mengstr/XSNOR/Assets/XSNOR-Megacalculator.bmp

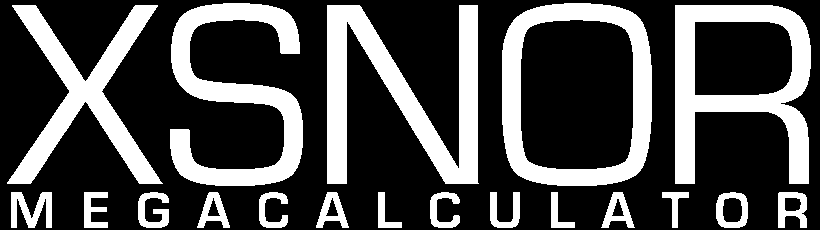
Assets/XSNOR-Megacalculator.bmp
