mengstr/XSNOR/Spice/main_test.asc

R1: res; 20
V1: voltage; 3; Rser=0
V2: voltage; PULSE(0.1 2.9 10m 100n 100n 20m 40m 1)
X1: AddSub
X2: AddSub
Named nets: 0, +, A
.tran 50m
