mengstr/XSNOR/Spice/Jonsson.asc

X1: NOR2
X2: NOR2
X3: NOR2
X4: NOR2
X5: NOR2
X6: NOR2
X7: NOR3
X8: NOR3
X9: INV
Named nets: +, CLK, J, K, CLR, Q, /Q
