mengstr/XSNOR/Spice/Jonsson12.asc

V1: voltage; 3
V2: voltage; PULSE(0 3 50m 0.1m 0.1m 5m 10m 24)
V3: voltage; PULSE(0 3 5m 0.1m 0.1m 5m 10m 1)
X1: Jonsson
X2: Jonsson
X3: Jonsson
X4: Jonsson
X5: Jonsson
X6: Jonsson
X7: NOR2
X8: NOR2
X9: NOR2
X10: NOR2
X11: NOR2
X12: NOR2
X13: NOR2
X14: NOR2
X15: NOR2
X16: NOR2
X17: NOR2
X18: NOR2
X19: Jonsson
X20: Jonsson
X21: Jonsson
X22: Jonsson
X23: Jonsson
X24: Jonsson
X25: NOR3
X26: NOR3
X27: NOR3
X28: NOR3
X29: NOR3
X30: NOR3
X31: NOR3
X32: NOR3
X33: NOR3
X34: NOR3
X35: NOR3
X36: NOR3
X37: Jonsson
X38: Jonsson
X39: Jonsson
X40: Jonsson
X41: Jonsson
X42: Jonsson
X43: NOR3
X44: NOR3
X45: NOR3
X46: NOR3
X47: NOR3
X48: NOR3
X49: NOR3
X50: NOR3
X51: NOR3
X52: NOR3
X53: NOR3
X54: NOR3
Named nets: +, 0, CLK, CLR, Q0, Q1, Q2, Q3, Q4, Q5, Q6, Q7, Q8, Q9, Q10, Q11, QQ0, QQ1, QQ2, QQ3, QQ4, QQ5, QQ6, QQ7, QQ8, QQ9, QQ10, QQ11, QQQ0, QQQ1, QQQ2, QQQ3, QQQ4, QQQ5, QQQ7, QQQ8, QQQ9, QQQ10, QQQ11
.tran 300m
