mengstr/XSNOR/Spice/_Keyboard.asc

V1: voltage; 3
V2: voltage; PULSE(0 3 0m 1m 1m 50m 100m 1)
V3: voltage; PULSE(0 3 100m 1m 1m 50m 100m 1)
V4: voltage; PULSE(0 3 200m 1m 1m 50m 100m 1)
V5: voltage; PULSE(0 3 300m 1m 1m 50m 100m 1)
V6: voltage; PULSE(0 3 400m 1m 1m 50m 100m 1)
V7: voltage; PULSE(0 3 500m 1m 1m 50m 100m 1)
V8: voltage; PULSE(0 3 600m 1m 1m 50m 100m 1)
V9: voltage; PULSE(0 3 700m 1m 1m 50m 100m 1)
V10: voltage; PULSE(0 3 800m 1m 1m 50m 100m 1)
V11: voltage; PULSE(0 3 900m 1m 1m 50m 100m 1)
V12: voltage; PULSE(0 3 1000m 1m 1m 50m 100m 1)
V13: voltage; PULSE(0 3 25m 1n 1n 1n 100m 10)
X1: Keyboard
Named nets: 0, +, PULSE, D0, D1, D2, D3, STB, key0, key1, key2, key3, key4, key5, key6, key7, key8, key9, keyx, AKD
.tran 999m
