mengstr/XSNOR/Spice/Keyboard.asc

C1: cap; 100n
C2: cap; 100n
M1: nmos; 2N7002
M2: nmos; 2N7002
M3: nmos; 2N7002
M4: nmos; 2N7002
M5: nmos; 2N7002
M6: nmos; 2N7002
M7: nmos; 2N7002
M8: nmos; 2N7002
M9: nmos; 2N7002
M10: nmos; 2N7002
M11: nmos; 2N7002
M12: nmos; 2N7002
M13: nmos; 2N7002
M14: nmos; 2N7002
M15: nmos; 2N7002
M16: nmos; 2N7002
M17: nmos; 2N7002
M18: nmos; 2N7002
M19: nmos; 2N7002
M20: nmos; 2N7002
M21: nmos; 2N7002
M22: nmos; 2N7002
M23: nmos; 2N7002
M24: nmos; 2N7002
M25: nmos; 2N7002
M26: nmos; 2N7002
M28: nmos; 2N7002
M30: nmos; 2N7002
M31: nmos; 2N7002
M32: nmos; 2N7002
M33: nmos; 2N7002
M34: nmos; 2N7002
M36: nmos; 2N7002
M39: nmos; 2N7002
M40: nmos; 2N7002
R1: res; {r}
R2: res; {r}
R3: res; {r}
R4: res; {r}
R5: res; {r}
R6: res; {r}
R7: res; {r}
R8: res; {r}
R9: res; {r}
R10: res; {r}
R11: res; {r}
R12: res; {r}
R13: res; {r}
R14: res; {r}
R15: res; {r}
R16: res; {r}
R17: res; {r}
R18: res; {r}
R19: res; {r}
R20: res; {r}
R21: res; {r}
R22: res; {r}
R23: res; {r}
R24: res; {r}
R25: res; {r}
R26: res; {r}
R27: res; {r}
V2: voltage; 3; Rser=100
Named nets: 0, KEY0, KEY1, KEY2, KEY3, KEY4, KEY5, KEY6, KEY7, KEY8, KEY9, /D0, /D1, /D2, /D3, +, D0, D1, D2, D3, AKD, KEYX, STB
.tran 1500m
.param r=1Meg
