mengstr/XSNOR/Spice/AddSub.asc

X1: FA
X2: FA
X3: FA
X4: FA
X5: INV
X6: FA
X7: FA
X8: FA
X9: INV
X10: NOR2
X11: NOR2
X12: NOR2
X13: NOR2
X14: NOR2
X15: NOR2
X16: NOR2
X17: NOR2
X18: NOR2
X19: NOR2
X20: NOR2
X21: NOR2
X22: INV
X23: INV
X24: INV
X25: INV
X26: INV
Named nets: +, OP, Ci, A0, A1, A2, A3, B0, B1, B2, B3, S0, S1, S2, S3, Co
