mengstr/XSNOR/Spice/FA.asc

X1: NOR2
X2: NOR2
X3: NOR2
X4: NOR2
X5: NOR2
X6: NOR2
X7: NOR2
X8: NOR2
X9: NOR2
Named nets: +, A, B, Ci, Co, S
