mengstr/XSNOR/Spice/INV.asc

M1: nmos; 2N7002
R1: res; 1Meg
Named nets: 0, A, Q, +
