mengstr/XSNOR/Spice/main.asc

R1: res; 20
V1: voltage; 3; Rser=0
V2: voltage; PULSE(0.1 2.9 0.1 100n 100n 0.1 0.2 4)
V3: voltage; PULSE(0.2 2.8 0.2 100n 100n 0.2 0.4 2)
V4: voltage; PULSE(0.3 2.7 0.4 100n 100n 0.4 0.8 1)
X1: AddSub
X2: AddSub
X3: AddSub
X4: AddSub
X5: AddSub
X6: AddSub
X7: AddSub
X8: AddSub
X9: AddSub
X10: AddSub
Named nets: 0, +, A, B
.tran 0.8s
