mengstr/XSNOR/Spice/NOR3.asc

M1: nmos; 2N7002
M2: nmos; 2N7002
M3: nmos; 2N7002
R1: res; 3meg
Named nets: 0, A, Q, +, B, C
