mengstr/XSNOR/(list of files, drawings)

Other design files:
Logisim/Johnson.circ
Logisim/ShiftRegister.circ
