mengstr/XSNOR/Eagle/ShiftReg.brd

## EAGLE design Eagle/ShiftReg.brd (2018-01-12)

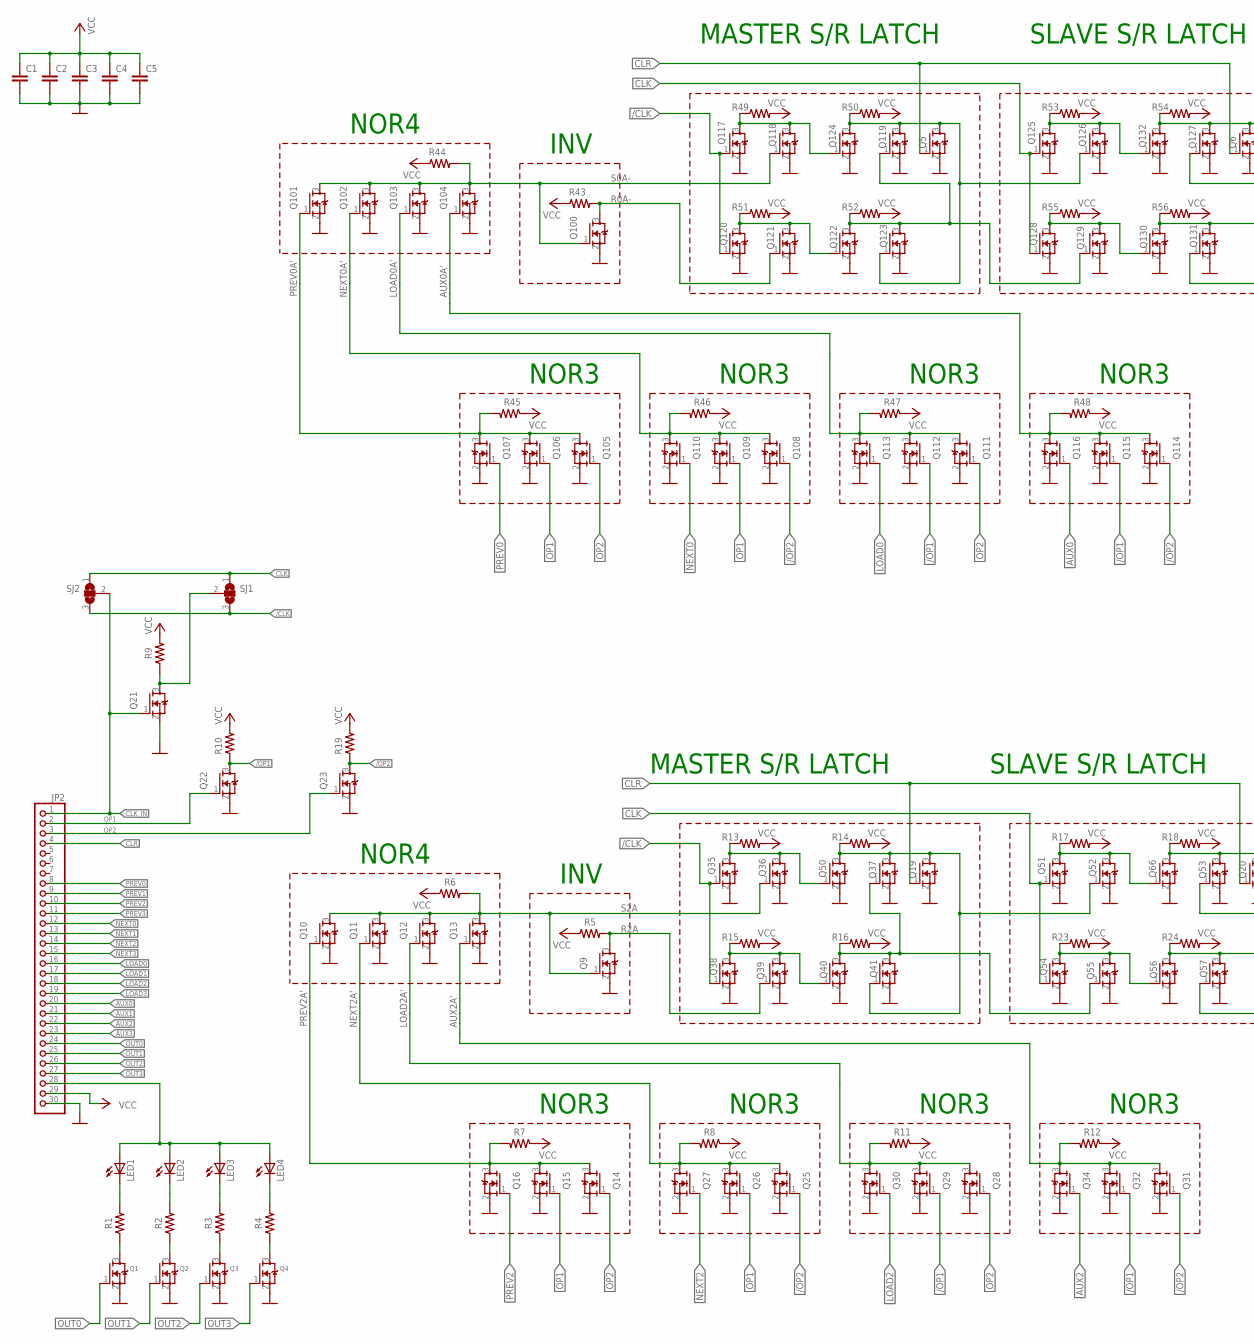
[picture p2: schematic ShiftReg.sch, part in row 1, column 1]

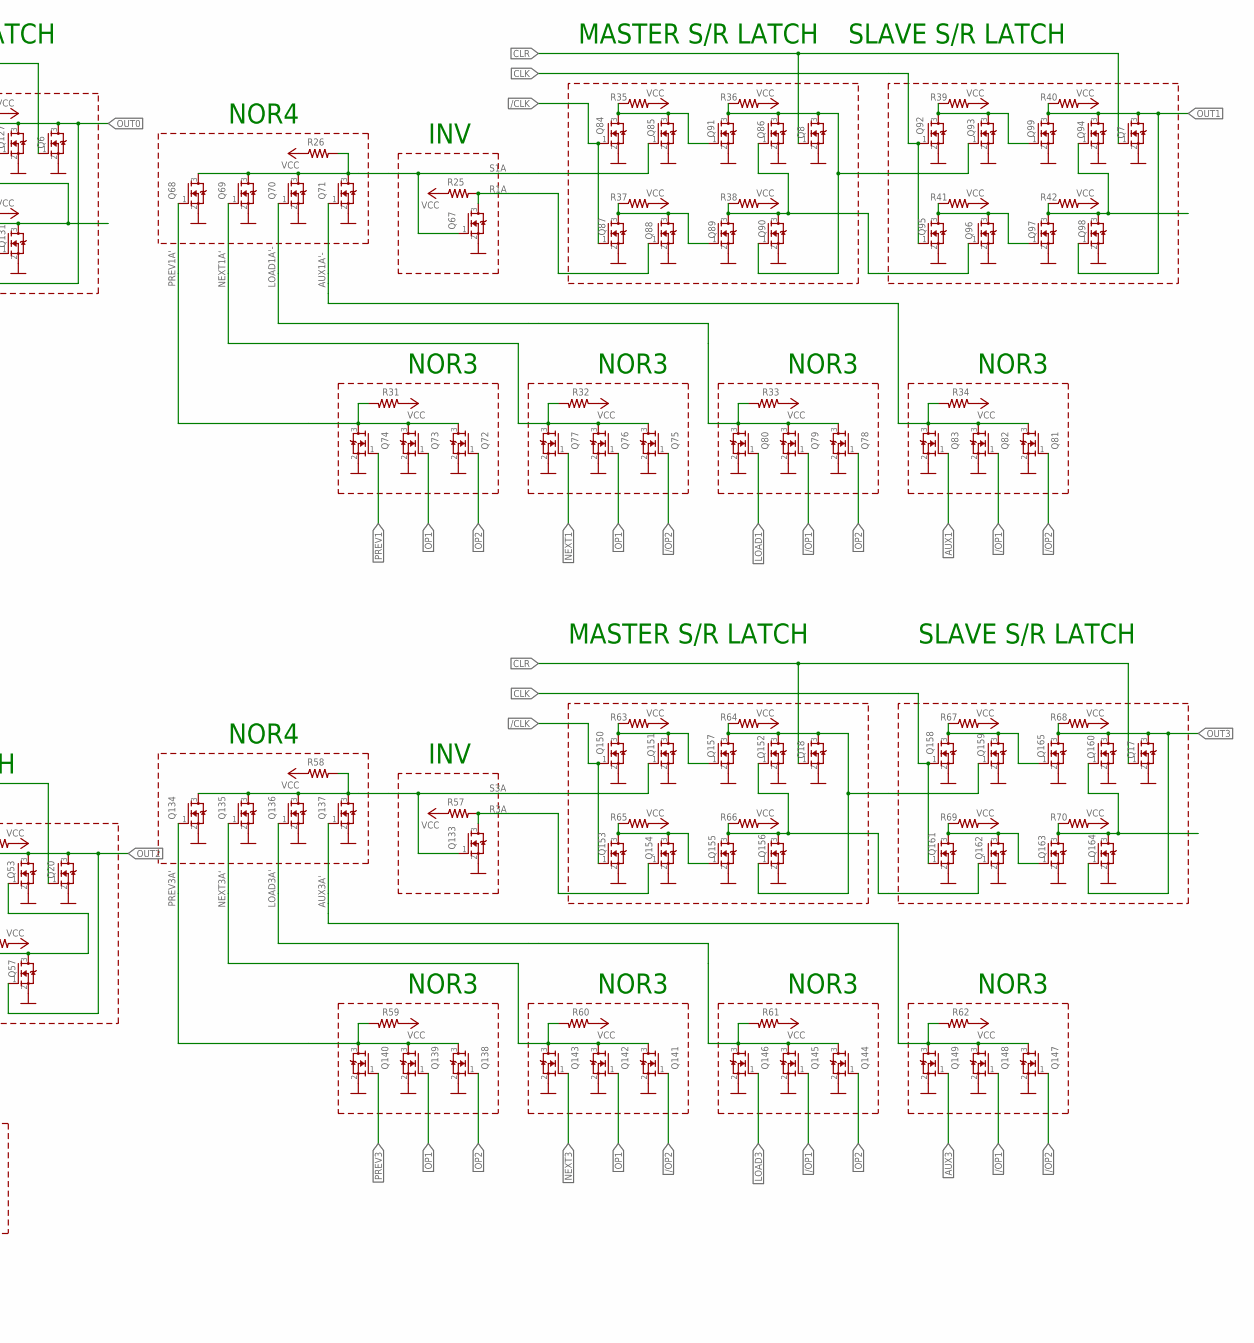
[picture p3: schematic ShiftReg.sch, part in row 1, column 2]

Parts:
C1, C2, C3, C4, C5: C-EUC0805K; C0805K
JP2: PINHD-1X30; 1X30
LED1, LED2, LED3, LED4: LEDSQR2X5; LED2X5
Q1, Q2, Q3, Q4: NMOSREFLOW; SOT23
Q5, Q6, Q7, Q8, Q9, Q10, Q11, Q12, Q13, Q14, Q15, Q16, Q17, Q18, Q19, Q20, Q21, Q22, Q23, Q25, Q26, Q27, Q28, Q29, Q30, Q31, Q32, Q34, Q35, Q36, Q37, Q38, Q39, Q40, Q41, Q50, Q51, Q52, Q53, Q54, Q55, Q56, Q57, Q66, Q67, Q68, Q69, Q70, Q71, Q72, Q73, Q74, Q75, Q76, Q77, Q78, Q79, Q80, Q81, Q82, Q83, Q84, Q85, Q86, Q87, Q88, Q89, Q90, Q91, Q92, Q93, Q94, Q95, Q96, Q97, Q98, Q99, Q100, Q101, Q102, Q103, Q104, Q105, Q106, Q107, Q108, Q109, Q110, Q111, Q112, Q113, Q114, Q115, Q116, Q117, Q118, Q119, Q120, Q121, Q122, Q123, Q124, Q125, Q126, Q127, Q128, Q129, Q130, Q131, Q132, Q133, Q134, Q135, Q136, Q137, Q138, Q139, Q140, Q141, Q142, Q143, Q144, Q145, Q146, Q147, Q148, Q149, Q150, Q151, Q152, Q153, Q154, Q155, Q156, Q157, Q158, Q159, Q160, Q161, Q162, Q163, Q164, Q165: 310mA/60V/1.6Ω; SOT23
R1, R2, R3, R4, R5, R6, R7, R8, R9, R10, R11, R12, R13, R14, R15, R16, R17, R18, R19, R23, R24, R25, R26, R31, R32, R33, R34, R35, R36, R37, R38, R39, R40, R41, R42, R43, R44, R45, R46, R47, R48, R49, R50, R51, R52, R53, R54, R55, R56, R57, R58, R59, R60, R61, R62, R63, R64, R65, R66, R67, R68, R69, R70: 0805
SJ1, SJ2: SJ2W; SJ_2

Connections:
/CLK: Q35.1 (G), Q38.1 (G), Q84.1 (G), Q87.1 (G), Q117.1 (G), Q120.1 (G), Q150.1 (G), Q153.1 (G), SJ1.3, SJ2.3
/OP1: Q22.3 (D), Q29.1 (G), Q32.1 (G), Q79.1 (G), Q82.1 (G), Q112.1 (G), Q115.1 (G), Q145.1 (G), Q148.1 (G), R10.1
/OP2: Q23.3 (D), Q25.1 (G), Q31.1 (G), Q75.1 (G), Q81.1 (G), Q108.1 (G), Q114.1 (G), Q141.1 (G), Q147.1 (G), R19.1
AUX0: JP2.20, Q116.1 (G)
AUX0A': Q104.1 (G), Q114.3 (D), Q115.3 (D), Q116.3 (D), R48.2
AUX1: JP2.21, Q83.1 (G)
AUX1A'-: Q71.1 (G), Q81.3 (D), Q82.3 (D), Q83.3 (D), R34.2
AUX2: JP2.22, Q34.1 (G)
AUX2A': Q13.1 (G), Q31.3 (D), Q32.3 (D), Q34.3 (D), R12.2
AUX3: JP2.23, Q149.1 (G)
AUX3A': Q137.1 (G), Q147.3 (D), Q148.3 (D), Q149.3 (D), R62.2
CLK: Q51.1 (G), Q54.1 (G), Q92.1 (G), Q95.1 (G), Q125.1 (G), Q128.1 (G), Q158.1 (G), Q161.1 (G), SJ1.1, SJ2.1
CLK_IN: JP2.1, Q21.1 (G), SJ2.2
CLR: JP2.4, Q5.1 (G), Q6.1 (G), Q7.1 (G), Q8.1 (G), Q17.1 (G), Q18.1 (G), Q19.1 (G), Q20.1 (G)
GND: C1.2, C2.2, C3.2, C4.2, C5.2, JP2.30, Q1.2 (S), Q2.2 (S), Q3.2 (S), Q4.2 (S), Q5.2 (S), Q6.2 (S), Q7.2 (S), Q8.2 (S), Q9.2 (S), Q10.2 (S), Q11.2 (S), Q12.2 (S), Q13.2 (S), Q14.2 (S), Q15.2 (S), Q16.2 (S), Q17.2 (S), Q18.2 (S), Q19.2 (S), Q20.2 (S), Q21.2 (S), Q22.2 (S), Q23.2 (S), Q25.2 (S), Q26.2 (S), Q27.2 (S), Q28.2 (S), Q29.2 (S), Q30.2 (S), Q31.2 (S), Q32.2 (S), Q34.2 (S), Q35.2 (S), Q36.2 (S), Q37.2 (S), Q38.2 (S), Q39.2 (S), Q40.2 (S), Q41.2 (S), Q50.2 (S), Q51.2 (S), Q52.2 (S), Q53.2 (S), Q54.2 (S), Q55.2 (S), Q56.2 (S), Q57.2 (S), Q66.2 (S), Q67.2 (S), Q68.2 (S), Q69.2 (S), Q70.2 (S), Q71.2 (S), Q72.2 (S), Q73.2 (S), Q74.2 (S), Q75.2 (S), Q76.2 (S), Q77.2 (S), Q78.2 (S), Q79.2 (S), Q80.2 (S), Q81.2 (S), Q82.2 (S), Q83.2 (S), Q84.2 (S), Q85.2 (S), Q86.2 (S), Q87.2 (S), Q88.2 (S), Q89.2 (S), Q90.2 (S), Q91.2 (S), Q92.2 (S), Q93.2 (S), Q94.2 (S), Q95.2 (S), Q96.2 (S), Q97.2 (S), Q98.2 (S), Q99.2 (S), Q100.2 (S), Q101.2 (S), Q102.2 (S), Q103.2 (S), Q104.2 (S), Q105.2 (S), Q106.2 (S), Q107.2 (S), Q108.2 (S), Q109.2 (S), Q110.2 (S), Q111.2 (S), Q112.2 (S), Q113.2 (S), Q114.2 (S), Q115.2 (S), Q116.2 (S), Q117.2 (S), Q118.2 (S), Q119.2 (S), Q120.2 (S), Q121.2 (S), Q122.2 (S), Q123.2 (S), Q124.2 (S), Q125.2 (S), Q126.2 (S), Q127.2 (S), Q128.2 (S), Q129.2 (S), Q130.2 (S), Q131.2 (S), Q132.2 (S), Q133.2 (S), Q134.2 (S), Q135.2 (S), Q136.2 (S), Q137.2 (S), Q138.2 (S), Q139.2 (S), Q140.2 (S), Q141.2 (S), Q142.2 (S), Q143.2 (S), Q144.2 (S), Q145.2 (S), Q146.2 (S), Q147.2 (S), Q148.2 (S), Q149.2 (S), Q150.2 (S), Q151.2 (S), Q152.2 (S), Q153.2 (S), Q154.2 (S), Q155.2 (S), Q156.2 (S), Q157.2 (S), Q158.2 (S), Q159.2 (S), Q160.2 (S), Q161.2 (S), Q162.2 (S), Q163.2 (S), Q164.2 (S), Q165.2 (S)
LED+: JP2.28, LED1.A, LED2.A, LED3.A, LED4.A
LOAD0: JP2.16, Q113.1 (G)
LOAD0A': Q103.1 (G), Q111.3 (D), Q112.3 (D), Q113.3 (D), R47.2
LOAD1: JP2.17, Q80.1 (G)
LOAD1A'-: Q70.1 (G), Q78.3 (D), Q79.3 (D), Q80.3 (D), R33.2
LOAD2: JP2.18, Q30.1 (G)
LOAD2A': Q12.1 (G), Q28.3 (D), Q29.3 (D), Q30.3 (D), R11.2
LOAD3: JP2.19, Q146.1 (G)
LOAD3A': Q136.1 (G), Q144.3 (D), Q145.3 (D), Q146.3 (D), R61.2
unnamed: Q35.3 (D), Q36.3 (D), Q50.1 (G), R13.1
unnamed: Q38.3 (D), Q39.3 (D), Q40.1 (G), R15.1
unnamed: Q21.3 (D), R9.1, SJ1.2
unnamed: Q51.3 (D), Q52.3 (D), Q66.1 (G), R17.1
unnamed: Q1.3 (D), R1.1
unnamed: Q2.3 (D), R2.1
unnamed: Q54.3 (D), Q55.3 (D), Q56.1 (G), R23.1
unnamed: Q84.3 (D), Q85.3 (D), Q91.1 (G), R35.1
unnamed: Q87.3 (D), Q88.3 (D), Q89.1 (G), R37.1
unnamed: Q92.3 (D), Q93.3 (D), Q99.1 (G), R39.1
unnamed: Q95.3 (D), Q96.3 (D), Q97.1 (G), R41.1
unnamed: Q150.3 (D), Q151.3 (D), Q157.1 (G), R63.1
unnamed: Q153.3 (D), Q154.3 (D), Q155.1 (G), R65.1
unnamed: Q158.3 (D), Q159.3 (D), Q165.1 (G), R67.1
unnamed: Q161.3 (D), Q162.3 (D), Q163.1 (G), R69.1
unnamed: Q117.3 (D), Q118.3 (D), Q124.1 (G), R49.1
unnamed: Q120.3 (D), Q121.3 (D), Q122.1 (G), R51.1
unnamed: Q125.3 (D), Q126.3 (D), Q132.1 (G), R53.1
unnamed: Q128.3 (D), Q129.3 (D), Q130.1 (G), R55.1
unnamed: Q3.3 (D), R3.1
unnamed: Q4.3 (D), R4.1
unnamed: LED4.K (C), R4.2
unnamed: LED3.K (C), R3.2
unnamed: LED2.K (C), R2.2
unnamed: LED1.K (C), R1.2
unnamed: Q5.3 (D), Q119.3 (D), Q123.1 (G), Q124.3 (D), Q126.1 (G), R50.1
unnamed: Q119.1 (G), Q122.3 (D), Q123.3 (D), Q129.1 (G), R52.1
unnamed: Q127.1 (G), Q130.3 (D), Q131.3 (D), R56.1
unnamed: Q86.1 (G), Q89.3 (D), Q90.3 (D), Q96.1 (G), R38.1
unnamed: Q8.3 (D), Q86.3 (D), Q90.1 (G), Q91.3 (D), Q93.1 (G), R36.1
unnamed: Q94.1 (G), Q97.3 (D), Q98.3 (D), R42.1
unnamed: Q53.1 (G), Q56.3 (D), Q57.3 (D), R24.1
unnamed: Q37.1 (G), Q40.3 (D), Q41.3 (D), Q55.1 (G), R16.1
unnamed: Q19.3 (D), Q37.3 (D), Q41.1 (G), Q50.3 (D), Q52.1 (G), R14.1
unnamed: Q160.1 (G), Q163.3 (D), Q164.3 (D), R70.1
unnamed: Q152.1 (G), Q155.3 (D), Q156.3 (D), Q162.1 (G), R66.1
unnamed: Q18.3 (D), Q152.3 (D), Q156.1 (G), Q157.3 (D), Q159.1 (G), R64.1
NEXT0: JP2.12, Q110.1 (G)
NEXT0A': Q102.1 (G), Q108.3 (D), Q109.3 (D), Q110.3 (D), R46.2
NEXT1: JP2.13, Q77.1 (G)
NEXT1A': Q69.1 (G), Q75.3 (D), Q76.3 (D), Q77.3 (D), R32.2
NEXT2: JP2.14, Q27.1 (G)
NEXT2A': Q11.1 (G), Q25.3 (D), Q26.3 (D), Q27.3 (D), R8.2
NEXT3: JP2.15, Q143.1 (G)
NEXT3A': Q135.1 (G), Q141.3 (D), Q142.3 (D), Q143.3 (D), R60.2
OP1: JP2.2, Q15.1 (G), Q22.1 (G), Q26.1 (G), Q73.1 (G), Q76.1 (G), Q106.1 (G), Q109.1 (G), Q139.1 (G), Q142.1 (G)
OP2: JP2.3, Q14.1 (G), Q23.1 (G), Q28.1 (G), Q72.1 (G), Q78.1 (G), Q105.1 (G), Q111.1 (G), Q138.1 (G), Q144.1 (G)
OUT0: JP2.24, Q1.1 (G), Q6.3 (D), Q127.3 (D), Q131.1 (G), Q132.3 (D), R54.1
OUT1: JP2.25, Q2.1 (G), Q7.3 (D), Q94.3 (D), Q98.1 (G), Q99.3 (D), R40.1
OUT2: JP2.26, Q3.1 (G), Q20.3 (D), Q53.3 (D), Q57.1 (G), Q66.3 (D), R18.1
OUT3: JP2.27, Q4.1 (G), Q17.3 (D), Q160.3 (D), Q164.1 (G), Q165.3 (D), R68.1
PREV0: JP2.8, Q107.1 (G)
PREV0A': Q101.1 (G), Q105.3 (D), Q106.3 (D), Q107.3 (D), R45.2
PREV1: JP2.9, Q74.1 (G)
PREV1A': Q68.1 (G), Q72.3 (D), Q73.3 (D), Q74.3 (D), R31.2
PREV2: JP2.10, Q16.1 (G)
PREV2A': Q10.1 (G), Q14.3 (D), Q15.3 (D), Q16.3 (D), R7.2
PREV3: JP2.11, Q140.1 (G)
PREV3A': Q134.1 (G), Q138.3 (D), Q139.3 (D), Q140.3 (D), R59.2
R0A-: Q100.3 (D), Q121.1 (G), R43.2
R1A: Q67.3 (D), Q88.1 (G), R25.2
R2A: Q9.3 (D), Q39.1 (G), R5.2
R3A: Q133.3 (D), Q154.1 (G), R57.2
S0A-: Q100.1 (G), Q101.3 (D), Q102.3 (D), Q103.3 (D), Q104.3 (D), Q118.1 (G), R44.2
S1A: Q67.1 (G), Q68.3 (D), Q69.3 (D), Q70.3 (D), Q71.3 (D), Q85.1 (G), R26.2
S2A: Q9.1 (G), Q10.3 (D), Q11.3 (D), Q12.3 (D), Q13.3 (D), Q36.1 (G), R6.2
S3A: Q133.1 (G), Q134.3 (D), Q135.3 (D), Q136.3 (D), Q137.3 (D), Q151.1 (G), R58.2
VCC: C1.1, C2.1, C3.1, C4.1, C5.1, JP2.29, R5.1, R6.1, R7.1, R8.1, R9.2, R10.2, R11.1, R12.1, R13.2, R14.2, R15.2, R16.2, R17.2, R18.2, R19.2, R23.2, R24.2, R25.1, R26.1, R31.1, R32.1, R33.1, R34.1, R35.2, R36.2, R37.2, R38.2, R39.2, R40.2, R41.2, R42.2, R43.1, R44.1, R45.1, R46.1, R47.1, R48.1, R49.2, R50.2, R51.2, R52.2, R53.2, R54.2, R55.2, R56.2, R57.1, R58.1, R59.1, R60.1, R61.1, R62.1, R63.2, R64.2, R65.2, R66.2, R67.2, R68.2, R69.2, R70.2

Notes on the sheet:
INV
NOR4
MASTER S/R LATCH
SLAVE S/R LATCH
NOR3

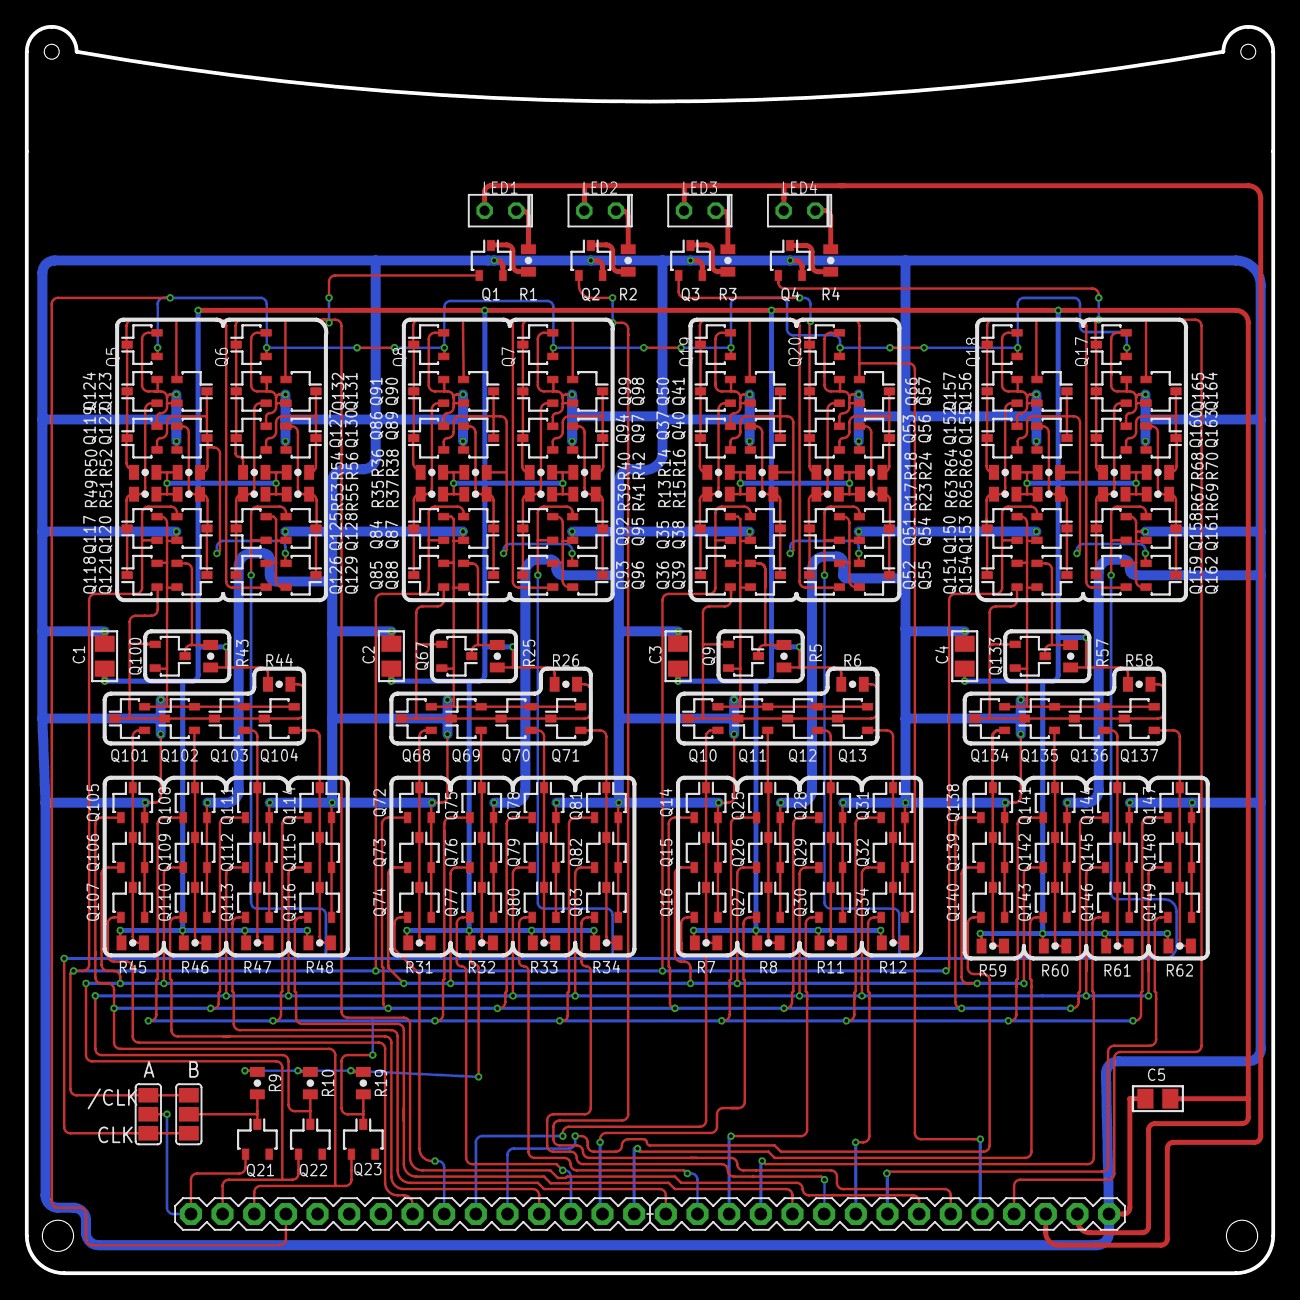
[picture p4: board ShiftReg.brd from above]

Board: 2 copper layers, 100.0 x 100.0 mm, 222 parts (0 on the bottom side), 92 nets.
