mengstr/XSNOR/Eagle/Keyboard.brd

## EAGLE design Eagle/Keyboard.brd (2018-01-05)

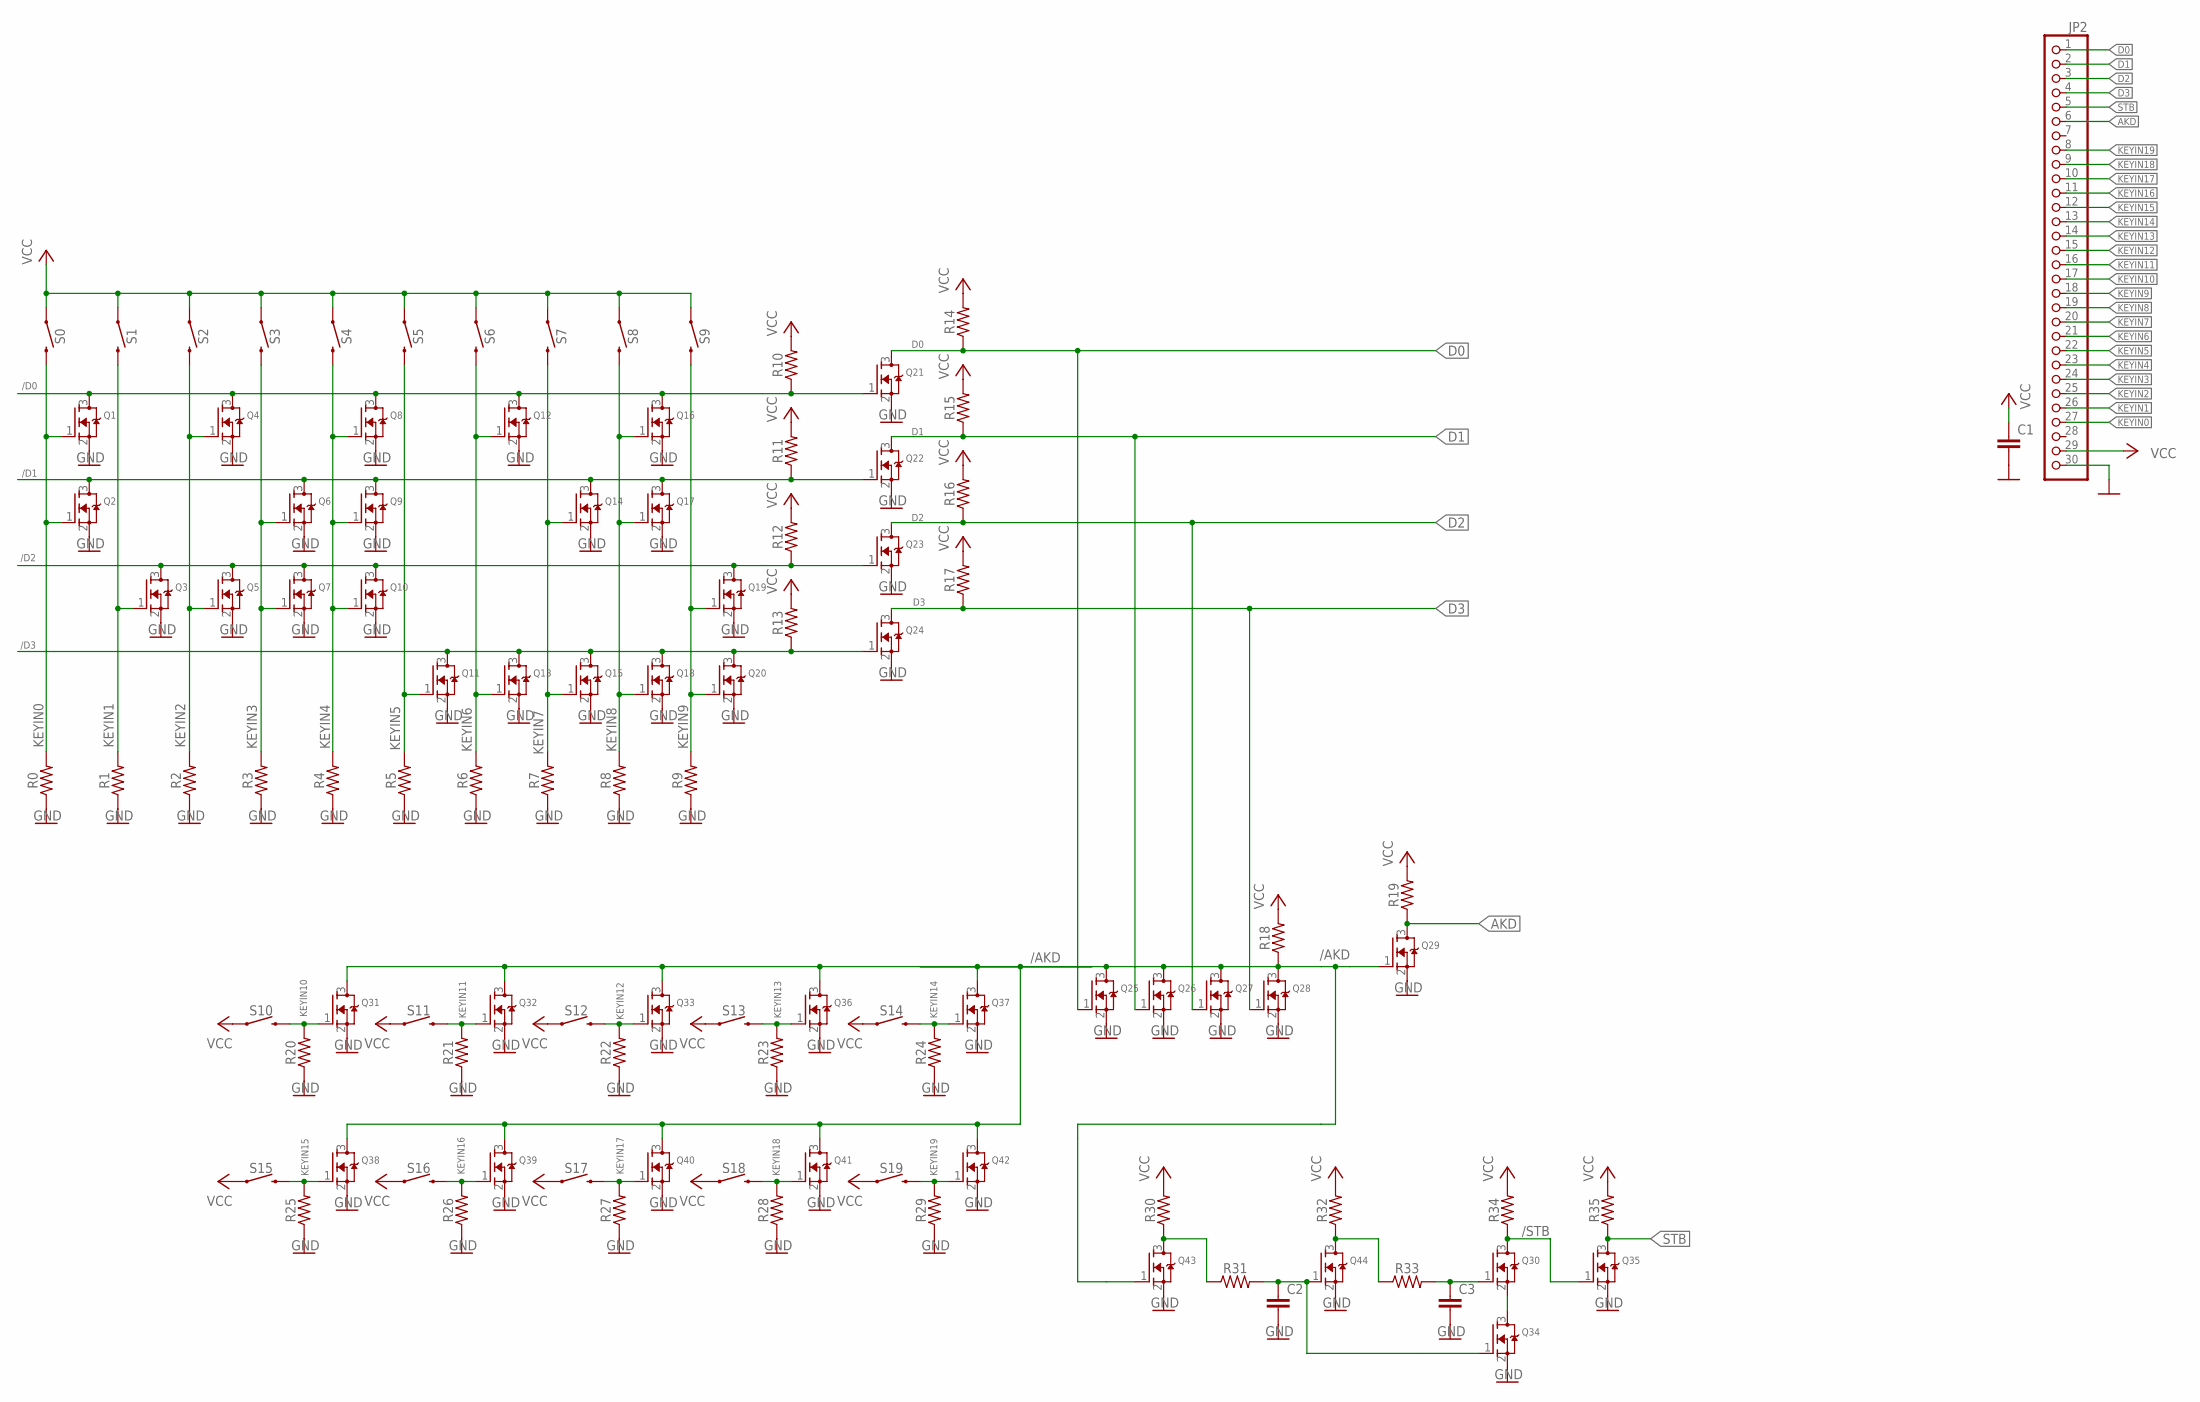
[picture p5: schematic Keyboard.sch]

Parts:
C1, C2, C3: C-EUC0805K; C0805K
JP2: PINHD-1X30; 1X30
Q1, Q2, Q3, Q4, Q5, Q6, Q7, Q8, Q9, Q10, Q11, Q12, Q13, Q14, Q15, Q16, Q17, Q18, Q19, Q20, Q21, Q22, Q23, Q24, Q25, Q26, Q27, Q28, Q29, Q30, Q31, Q32, Q33, Q34, Q35, Q36, Q37, Q38, Q39, Q40, Q41, Q42, Q43, Q44: NMOSREFLOW; SOT23
R0, R1, R2, R3, R4, R5, R6, R7, R8, R9, R10, R11, R12, R13, R14, R15, R16, R17, R18, R19, R20, R21, R22, R23, R24, R25, R26, R27, R28, R29, R30, R31, R32, R33, R34, R35: 0805
S0, S1, S2, S3, S4, S5, S6, S7, S8, S9, S10, S11, S12, S13, S14, S15, S16, S17, S18, S19: MOMENTARY-SWITCH-SPST-PTH-6.0MM; TACTILE_SWITCH_PTH_6.0MM

Connections:
/AKD: Q25.3 (D), Q26.3 (D), Q27.3 (D), Q28.3 (D), Q29.1 (G), Q31.3 (D), Q32.3 (D), Q33.3 (D), Q36.3 (D), Q37.3 (D), Q38.3 (D), Q39.3 (D), Q40.3 (D), Q41.3 (D), Q42.3 (D), Q43.1 (G), R18.1
/D0: Q1.3 (D), Q4.3 (D), Q8.3 (D), Q12.3 (D), Q16.3 (D), Q21.1 (G), R10.1
/D1: Q2.3 (D), Q6.3 (D), Q9.3 (D), Q14.3 (D), Q17.3 (D), Q22.1 (G), R11.1
/D2: Q3.3 (D), Q5.3 (D), Q7.3 (D), Q10.3 (D), Q19.3 (D), Q23.1 (G), R12.1
/D3: Q11.3 (D), Q13.3 (D), Q15.3 (D), Q18.3 (D), Q20.3 (D), Q24.1 (G), R13.1
/STB: Q30.3 (D), Q35.1 (G), R34.1
AKD: JP2.6, Q29.3 (D), R19.1
D0: JP2.1, Q21.3 (D), Q25.1 (G), R14.1
D1: JP2.2, Q22.3 (D), Q26.1 (G), R15.1
D2: JP2.3, Q23.3 (D), Q27.1 (G), R16.1
D3: JP2.4, Q24.3 (D), Q28.1 (G), R17.1
GND: C1.2, C2.2, C3.2, JP2.30, Q1.2 (S), Q2.2 (S), Q3.2 (S), Q4.2 (S), Q5.2 (S), Q6.2 (S), Q7.2 (S), Q8.2 (S), Q9.2 (S), Q10.2 (S), Q11.2 (S), Q12.2 (S), Q13.2 (S), Q14.2 (S), Q15.2 (S), Q16.2 (S), Q17.2 (S), Q18.2 (S), Q19.2 (S), Q20.2 (S), Q21.2 (S), Q22.2 (S), Q23.2 (S), Q24.2 (S), Q25.2 (S), Q26.2 (S), Q27.2 (S), Q28.2 (S), Q29.2 (S), Q31.2 (S), Q32.2 (S), Q33.2 (S), Q34.2 (S), Q35.2 (S), Q36.2 (S), Q37.2 (S), Q38.2 (S), Q39.2 (S), Q40.2 (S), Q41.2 (S), Q42.2 (S), Q43.2 (S), Q44.2 (S), R0.1, R1.1, R2.1, R3.1, R4.1, R5.1, R6.1, R7.1, R8.1, R9.1, R20.1, R21.1, R22.1, R23.1, R24.1, R25.1, R26.1, R27.1, R28.1, R29.1
KEYIN0: JP2.27, Q1.1 (G), Q2.1 (G), R0.2, S0.3 (2)
KEYIN1: JP2.26, Q3.1 (G), R1.2, S1.3 (2)
KEYIN2: JP2.25, Q4.1 (G), Q5.1 (G), R2.2, S2.3 (2)
KEYIN3: JP2.24, Q6.1 (G), Q7.1 (G), R3.2, S3.3 (2)
KEYIN4: JP2.23, Q8.1 (G), Q9.1 (G), Q10.1 (G), R4.2, S4.3 (2)
KEYIN5: JP2.22, Q11.1 (G), R5.2, S5.3 (2)
KEYIN6: JP2.21, Q12.1 (G), Q13.1 (G), R6.2, S6.3 (2)
KEYIN7: JP2.20, Q14.1 (G), Q15.1 (G), R7.2, S7.3 (2)
KEYIN8: JP2.19, Q16.1 (G), Q17.1 (G), Q18.1 (G), R8.2, S8.3 (2)
KEYIN9: JP2.18, Q19.1 (G), Q20.1 (G), R9.2, S9.3 (2)
KEYIN10: JP2.17, Q31.1 (G), R20.2, S10.3 (2)
KEYIN11: JP2.16, Q32.1 (G), R21.2, S11.3 (2)
KEYIN12: JP2.15, Q33.1 (G), R22.2, S12.3 (2)
KEYIN13: JP2.14, Q36.1 (G), R23.2, S13.3 (2)
KEYIN14: JP2.13, Q37.1 (G), R24.2, S14.3 (2)
KEYIN15: JP2.12, Q38.1 (G), R25.2, S15.3 (2)
KEYIN16: JP2.11, Q39.1 (G), R26.2, S16.3 (2)
KEYIN17: JP2.10, Q40.1 (G), R27.2, S17.3 (2)
KEYIN18: JP2.9, Q41.1 (G), R28.2, S18.3 (2)
KEYIN19: JP2.8, Q42.1 (G), R29.2, S19.3 (2)
unnamed: Q43.3 (D), R30.1, R31.1
unnamed: Q44.3 (D), R32.1, R33.1
unnamed: C3.1, Q30.1 (G), R33.2
unnamed: C2.1, Q34.1 (G), Q44.1 (G), R31.2
unnamed: Q30.2 (S), Q34.3 (D)
STB: JP2.5, Q35.3 (D), R35.1
VCC: C1.1, JP2.29, R10.2, R11.2, R12.2, R13.2, R14.2, R15.2, R16.2, R17.2, R18.2, R19.2, R30.2, R32.2, R34.2, R35.2, S0.1, S1.1, S2.1, S3.1, S4.1, S5.1, S6.1, S7.1, S8.1, S9.1, S10.1, S11.1, S12.1, S13.1, S14.1, S15.1, S16.1, S17.1, S18.1, S19.1

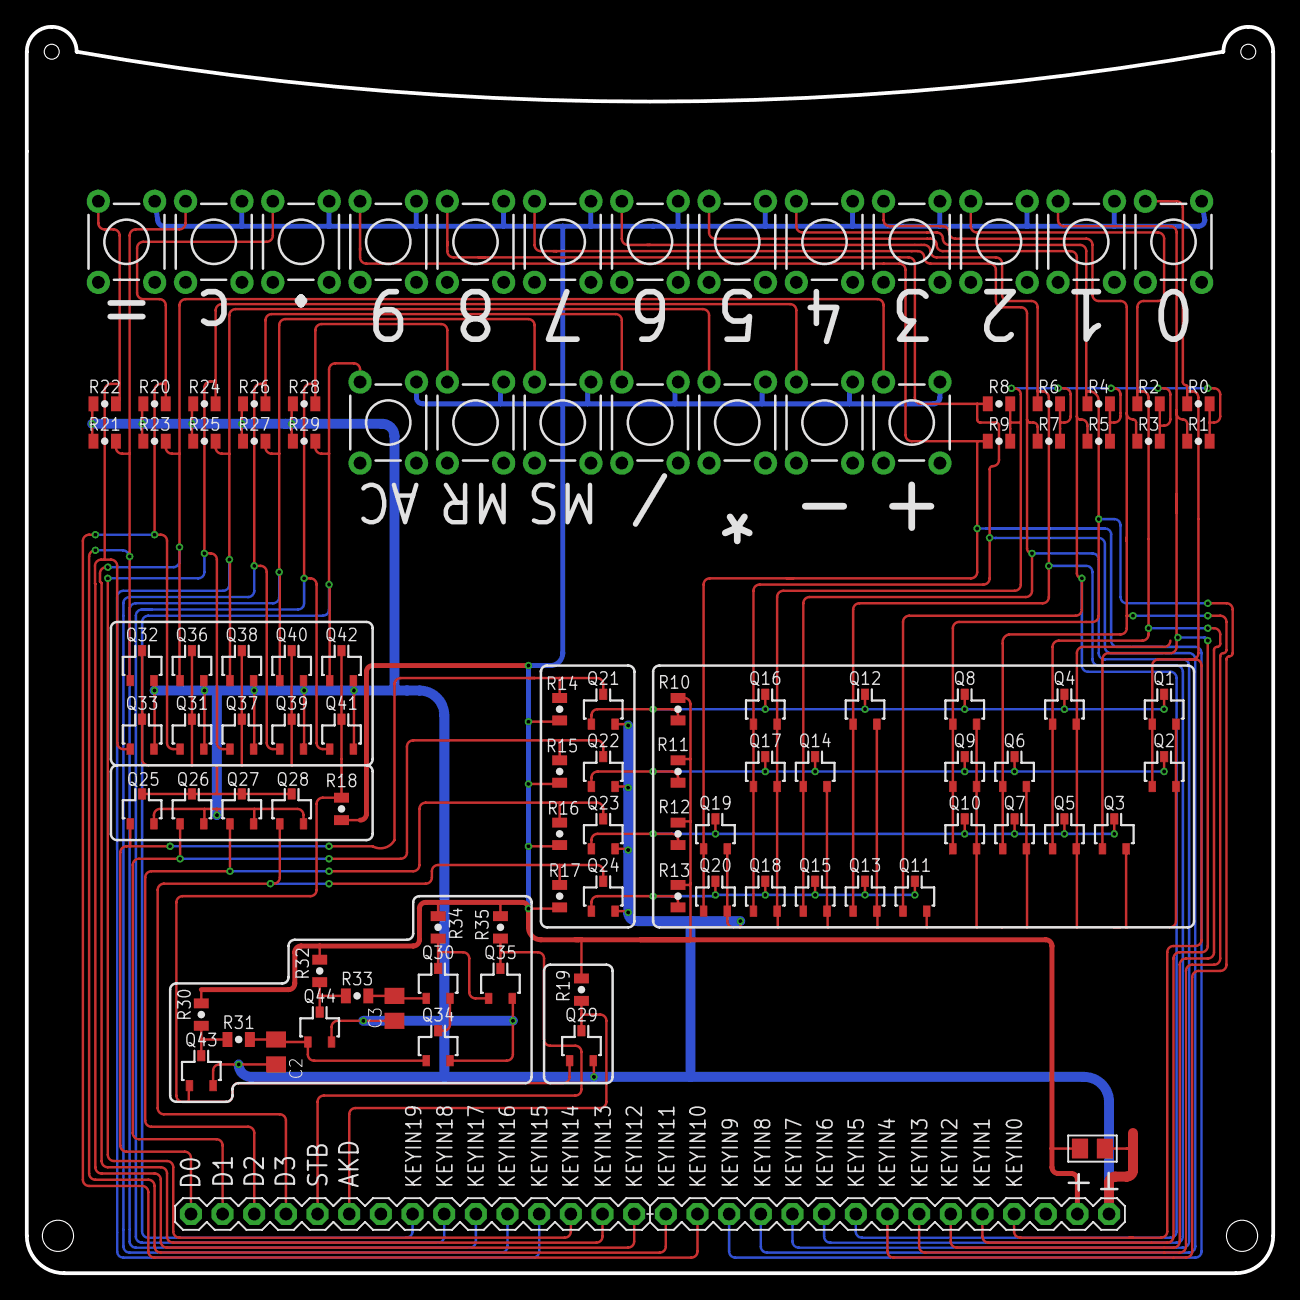
[picture p6: board Keyboard.brd from above]

Board: 2 copper layers, 100.0 x 100.0 mm, 104 parts (0 on the bottom side), 39 nets.
