mengstr/XSNOR/Eagle/Display.brd

## EAGLE design Eagle/Display.brd (2018-01-04)

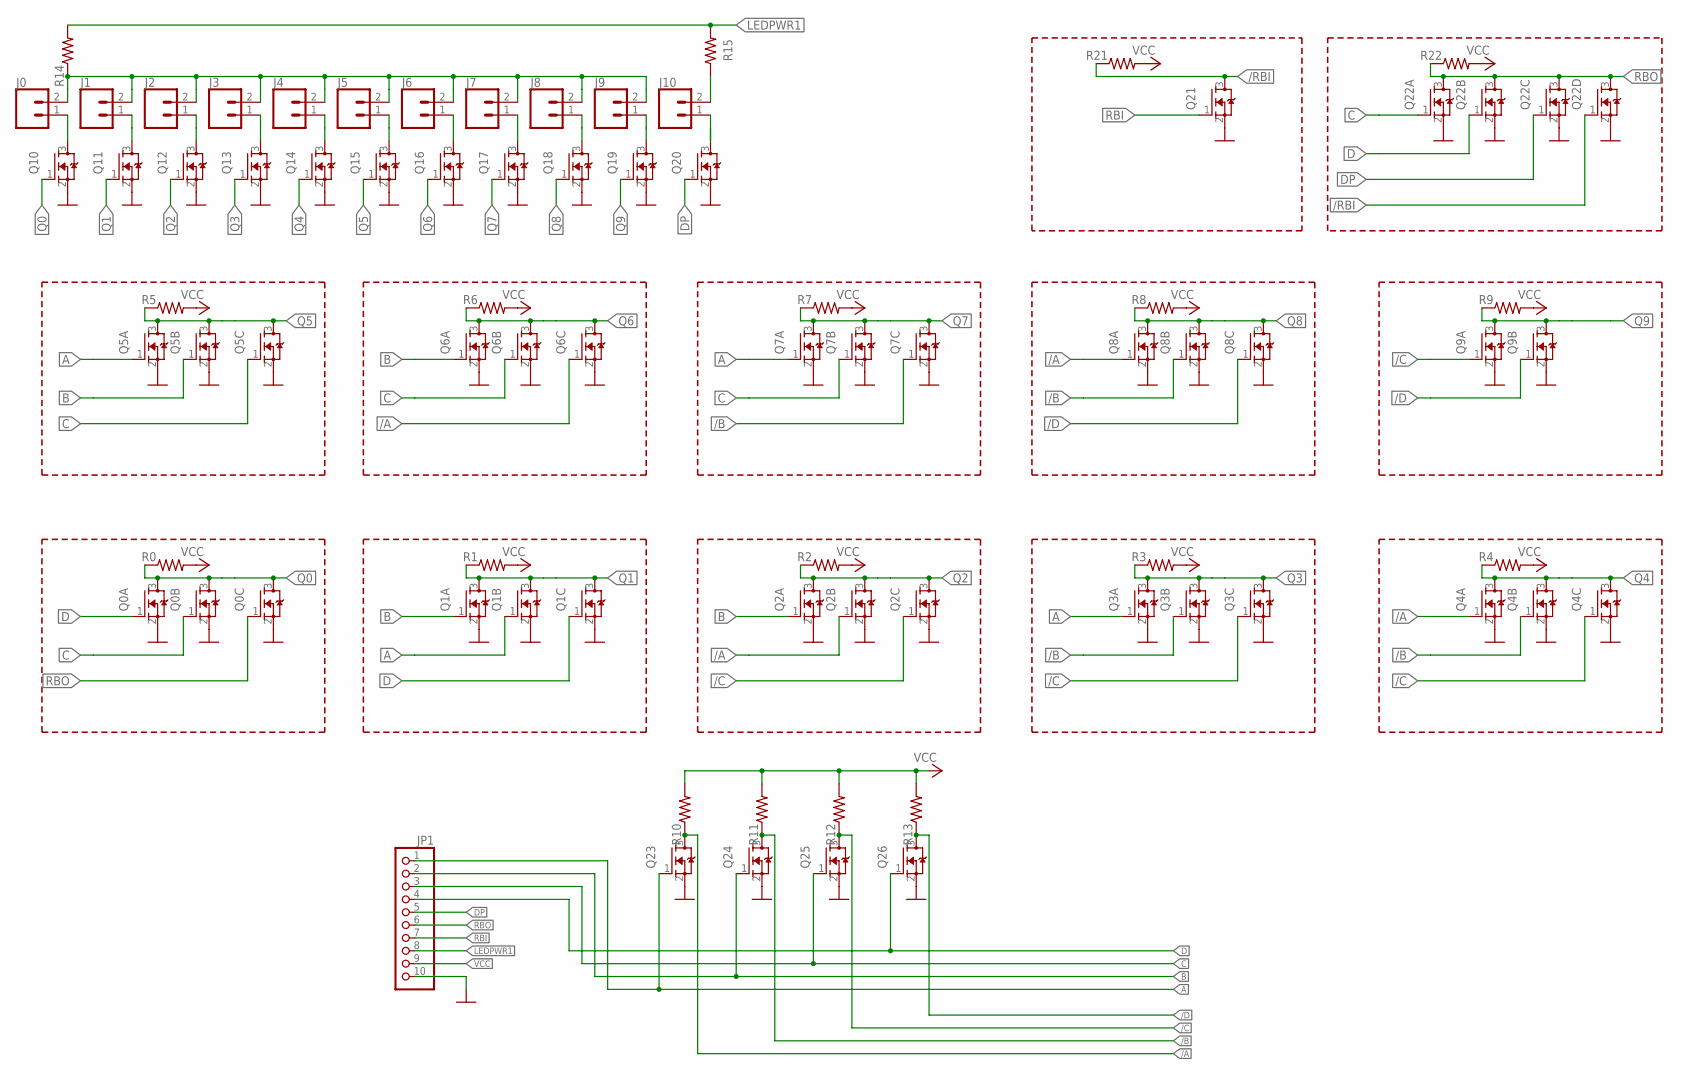
[picture p7: schematic Display.sch]

Parts:
J0, J1, J2, J3, J4, J5, J6, J7, J8, J9, J10: CONN_02; 1X02
JP1: PINHD-1X10/90; 1X10/90
Q0A, Q0B, Q0C, Q1A, Q1B, Q1C, Q2A, Q2B, Q2C, Q3A, Q3B, Q3C, Q4A, Q4B, Q4C, Q5A, Q5B, Q5C, Q6A, Q6B, Q6C, Q7A, Q7B, Q7C, Q8A, Q8B, Q8C, Q9A, Q9B, Q10, Q11, Q12, Q13, Q14, Q15, Q16, Q17, Q18, Q19, Q20, Q21, Q22A, Q22B, Q22C, Q22D, Q23, Q24, Q25, Q26: 310mA/60V/1.6Ω; SOT23
R0, R1, R2, R3, R4, R5, R6, R7, R8, R9, R10, R11, R12, R13, R14, R15, R21, R22: 0805

Connections:
/A: Q2B.1 (G), Q4A.1 (G), Q6C.1 (G), Q8A.1 (G), Q23.3 (D), R10.1
/B: Q3B.1 (G), Q4B.1 (G), Q7C.1 (G), Q8B.1 (G), Q24.3 (D), R11.1
/C: Q2C.1 (G), Q3C.1 (G), Q4C.1 (G), Q9A.1 (G), Q25.3 (D), R12.1
/D: Q8C.1 (G), Q9B.1 (G), Q26.3 (D), R13.1
/RBI: Q21.3 (D), Q22D.1 (G), R21.1
A: JP1.1, Q1B.1 (G), Q3A.1 (G), Q5A.1 (G), Q7A.1 (G), Q23.1 (G)
B: JP1.2, Q1A.1 (G), Q2A.1 (G), Q5B.1 (G), Q6A.1 (G), Q24.1 (G)
C: JP1.3, Q0B.1 (G), Q5C.1 (G), Q6B.1 (G), Q7B.1 (G), Q22A.1 (G), Q25.1 (G)
D: JP1.4, Q0A.1 (G), Q1C.1 (G), Q22B.1 (G), Q26.1 (G)
DP: JP1.5, Q20.1 (G), Q22C.1 (G)
GND: JP1.10, Q0A.2 (S), Q0B.2 (S), Q0C.2 (S), Q1A.2 (S), Q1B.2 (S), Q1C.2 (S), Q2A.2 (S), Q2B.2 (S), Q2C.2 (S), Q3A.2 (S), Q3B.2 (S), Q3C.2 (S), Q4A.2 (S), Q4B.2 (S), Q4C.2 (S), Q5A.2 (S), Q5B.2 (S), Q5C.2 (S), Q6A.2 (S), Q6B.2 (S), Q6C.2 (S), Q7A.2 (S), Q7B.2 (S), Q7C.2 (S), Q8A.2 (S), Q8B.2 (S), Q8C.2 (S), Q9A.2 (S), Q9B.2 (S), Q10.2 (S), Q11.2 (S), Q12.2 (S), Q13.2 (S), Q14.2 (S), Q15.2 (S), Q16.2 (S), Q17.2 (S), Q18.2 (S), Q19.2 (S), Q20.2 (S), Q21.2 (S), Q22A.2 (S), Q22B.2 (S), Q22C.2 (S), Q22D.2 (S), Q23.2 (S), Q24.2 (S), Q25.2 (S), Q26.2 (S)
LEDPWR: J0.2, J1.2, J2.2, J3.2, J4.2, J5.2, J6.2, J7.2, J8.2, J9.2, R14.1
LEDPWR1: JP1.8, R14.2, R15.2
unnamed: J0.1, Q10.3 (D)
unnamed: J1.1, Q11.3 (D)
unnamed: J2.1, Q12.3 (D)
unnamed: J3.1, Q13.3 (D)
unnamed: J4.1, Q14.3 (D)
unnamed: J5.1, Q15.3 (D)
unnamed: J6.1, Q16.3 (D)
unnamed: J7.1, Q17.3 (D)
unnamed: J10.2, R15.1
unnamed: J8.1, Q18.3 (D)
unnamed: J9.1, Q19.3 (D)
unnamed: J10.1, Q20.3 (D)
Q0: Q0A.3 (D), Q0B.3 (D), Q0C.3 (D), Q10.1 (G), R0.1
Q1: Q1A.3 (D), Q1B.3 (D), Q1C.3 (D), Q11.1 (G), R1.1
Q2: Q2A.3 (D), Q2B.3 (D), Q2C.3 (D), Q12.1 (G), R2.1
Q3: Q3A.3 (D), Q3B.3 (D), Q3C.3 (D), Q13.1 (G), R3.1
Q4: Q4A.3 (D), Q4B.3 (D), Q4C.3 (D), Q14.1 (G), R4.1
Q5: Q5A.3 (D), Q5B.3 (D), Q5C.3 (D), Q15.1 (G), R5.1
Q6: Q6A.3 (D), Q6B.3 (D), Q6C.3 (D), Q16.1 (G), R6.1
Q7: Q7A.3 (D), Q7B.3 (D), Q7C.3 (D), Q17.1 (G), R7.1
Q8: Q8A.3 (D), Q8B.3 (D), Q8C.3 (D), Q18.1 (G), R8.1
Q9: Q9A.3 (D), Q9B.3 (D), Q19.1 (G), R9.1
RBI: JP1.7, Q21.1 (G)
RBO: JP1.6, Q0C.1 (G), Q22A.3 (D), Q22B.3 (D), Q22C.3 (D), Q22D.3 (D), R22.1
VCC: JP1.9, R0.2, R1.2, R2.2, R3.2, R4.2, R5.2, R6.2, R7.2, R8.2, R9.2, R10.2, R11.2, R12.2, R13.2, R21.2, R22.2

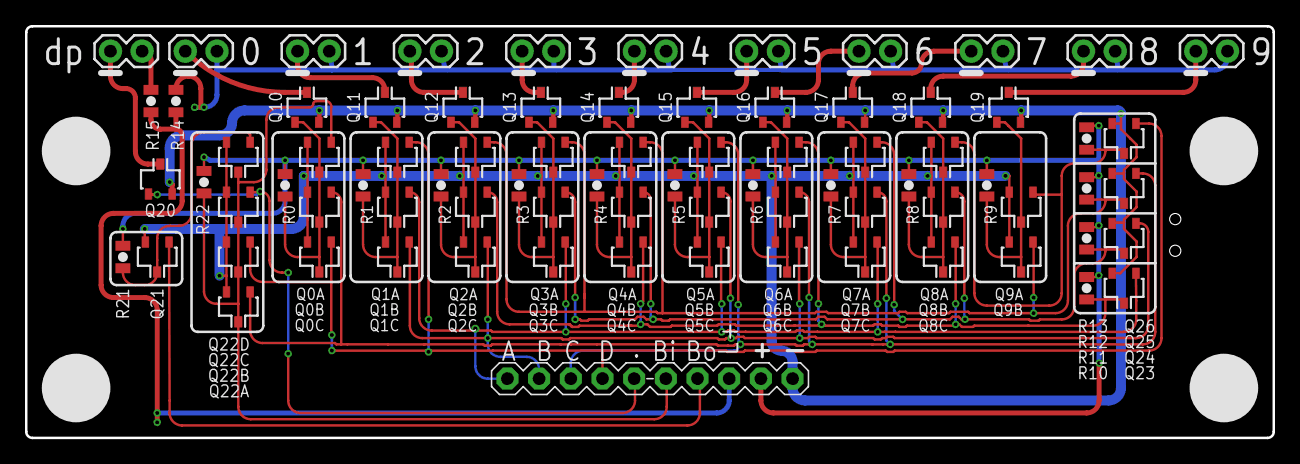
[picture p8: board Display.brd from above]

Board: 2 copper layers, 100.0 x 33.0 mm, 79 parts (0 on the bottom side), 38 nets.
