mengstr/XSNOR/Eagle/Backplane.brd

## EAGLE design Eagle/Backplane.brd (2018-01-04)

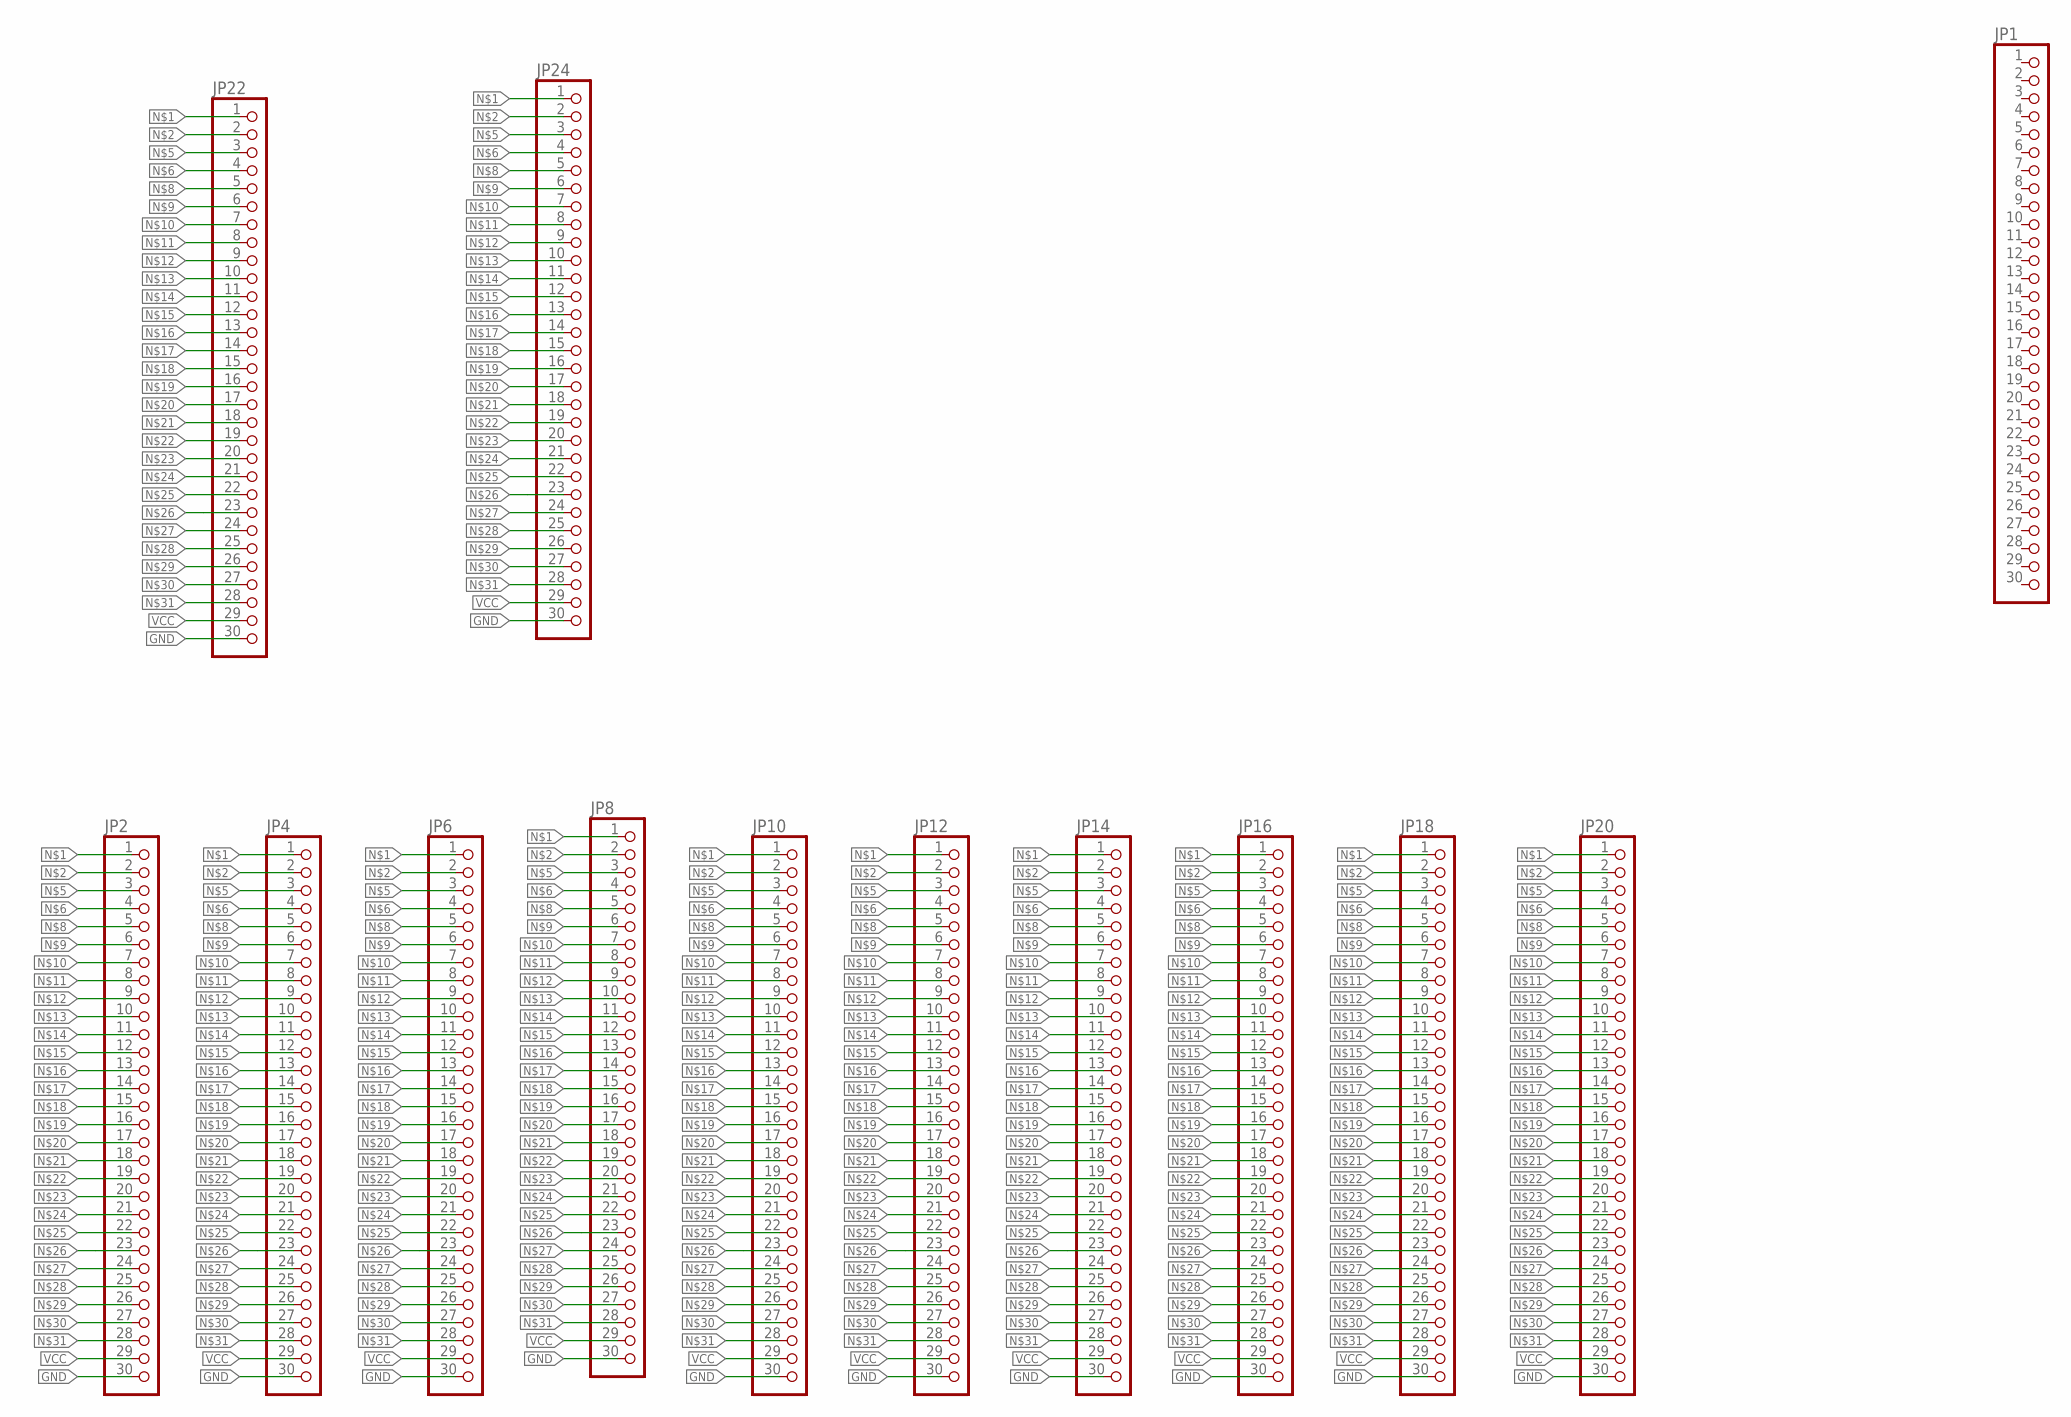
[picture p11: schematic Backplane.sch]

Parts:
JP1, JP2, JP4, JP6, JP8, JP10, JP12, JP14, JP16, JP18, JP20, JP22, JP24: PINHD-1X30; 1X30

Connections:
GND: JP2.30, JP4.30, JP6.30, JP8.30, JP10.30, JP12.30, JP14.30, JP16.30, JP18.30, JP20.30, JP22.30, JP24.30
unnamed: JP2.1, JP4.1, JP6.1, JP8.1, JP10.1, JP12.1, JP14.1, JP16.1, JP18.1, JP20.1, JP22.1, JP24.1
unnamed: JP2.2, JP4.2, JP6.2, JP8.2, JP10.2, JP12.2, JP14.2, JP16.2, JP18.2, JP20.2, JP22.2, JP24.2
unnamed: JP2.3, JP4.3, JP6.3, JP8.3, JP10.3, JP12.3, JP14.3, JP16.3, JP18.3, JP20.3, JP22.3, JP24.3
unnamed: JP2.4, JP4.4, JP6.4, JP8.4, JP10.4, JP12.4, JP14.4, JP16.4, JP18.4, JP20.4, JP22.4, JP24.4
unnamed: JP2.5, JP4.5, JP6.5, JP8.5, JP10.5, JP12.5, JP14.5, JP16.5, JP18.5, JP20.5, JP22.5, JP24.5
unnamed: JP2.6, JP4.6, JP6.6, JP8.6, JP10.6, JP12.6, JP14.6, JP16.6, JP18.6, JP20.6, JP22.6, JP24.6
unnamed: JP2.7, JP4.7, JP6.7, JP8.7, JP10.7, JP12.7, JP14.7, JP16.7, JP18.7, JP20.7, JP22.7, JP24.7
unnamed: JP2.8, JP4.8, JP6.8, JP8.8, JP10.8, JP12.8, JP14.8, JP16.8, JP18.8, JP20.8, JP22.8, JP24.8
unnamed: JP2.9, JP4.9, JP6.9, JP8.9, JP10.9, JP12.9, JP14.9, JP16.9, JP18.9, JP20.9, JP22.9, JP24.9
unnamed: JP2.10, JP4.10, JP6.10, JP8.10, JP10.10, JP12.10, JP14.10, JP16.10, JP18.10, JP20.10, JP22.10, JP24.10
unnamed: JP2.11, JP4.11, JP6.11, JP8.11, JP10.11, JP12.11, JP14.11, JP16.11, JP18.11, JP20.11, JP22.11, JP24.11
unnamed: JP2.12, JP4.12, JP6.12, JP8.12, JP10.12, JP12.12, JP14.12, JP16.12, JP18.12, JP20.12, JP22.12, JP24.12
unnamed: JP2.13, JP4.13, JP6.13, JP8.13, JP10.13, JP12.13, JP14.13, JP16.13, JP18.13, JP20.13, JP22.13, JP24.13
unnamed: JP2.14, JP4.14, JP6.14, JP8.14, JP10.14, JP12.14, JP14.14, JP16.14, JP18.14, JP20.14, JP22.14, JP24.14
unnamed: JP2.15, JP4.15, JP6.15, JP8.15, JP10.15, JP12.15, JP14.15, JP16.15, JP18.15, JP20.15, JP22.15, JP24.15
unnamed: JP2.16, JP4.16, JP6.16, JP8.16, JP10.16, JP12.16, JP14.16, JP16.16, JP18.16, JP20.16, JP22.16, JP24.16
unnamed: JP2.17, JP4.17, JP6.17, JP8.17, JP10.17, JP12.17, JP14.17, JP16.17, JP18.17, JP20.17, JP22.17, JP24.17
unnamed: JP2.18, JP4.18, JP6.18, JP8.18, JP10.18, JP12.18, JP14.18, JP16.18, JP18.18, JP20.18, JP22.18, JP24.18
unnamed: JP2.19, JP4.19, JP6.19, JP8.19, JP10.19, JP12.19, JP14.19, JP16.19, JP18.19, JP20.19, JP22.19, JP24.19
unnamed: JP2.20, JP4.20, JP6.20, JP8.20, JP10.20, JP12.20, JP14.20, JP16.20, JP18.20, JP20.20, JP22.20, JP24.20
unnamed: JP2.21, JP4.21, JP6.21, JP8.21, JP10.21, JP12.21, JP14.21, JP16.21, JP18.21, JP20.21, JP22.21, JP24.21
unnamed: JP2.22, JP4.22, JP6.22, JP8.22, JP10.22, JP12.22, JP14.22, JP16.22, JP18.22, JP20.22, JP22.22, JP24.22
unnamed: JP2.23, JP4.23, JP6.23, JP8.23, JP10.23, JP12.23, JP14.23, JP16.23, JP18.23, JP20.23, JP22.23, JP24.23
unnamed: JP2.24, JP4.24, JP6.24, JP8.24, JP10.24, JP12.24, JP14.24, JP16.24, JP18.24, JP20.24, JP22.24, JP24.24
unnamed: JP2.25, JP4.25, JP6.25, JP8.25, JP10.25, JP12.25, JP14.25, JP16.25, JP18.25, JP20.25, JP22.25, JP24.25
unnamed: JP2.26, JP4.26, JP6.26, JP8.26, JP10.26, JP12.26, JP14.26, JP16.26, JP18.26, JP20.26, JP22.26, JP24.26
unnamed: JP2.27, JP4.27, JP6.27, JP8.27, JP10.27, JP12.27, JP14.27, JP16.27, JP18.27, JP20.27, JP22.27, JP24.27
unnamed: JP2.28, JP4.28, JP6.28, JP8.28, JP10.28, JP12.28, JP14.28, JP16.28, JP18.28, JP20.28, JP22.28, JP24.28
VCC: JP2.29, JP4.29, JP6.29, JP8.29, JP10.29, JP12.29, JP14.29, JP16.29, JP18.29, JP20.29, JP22.29, JP24.29

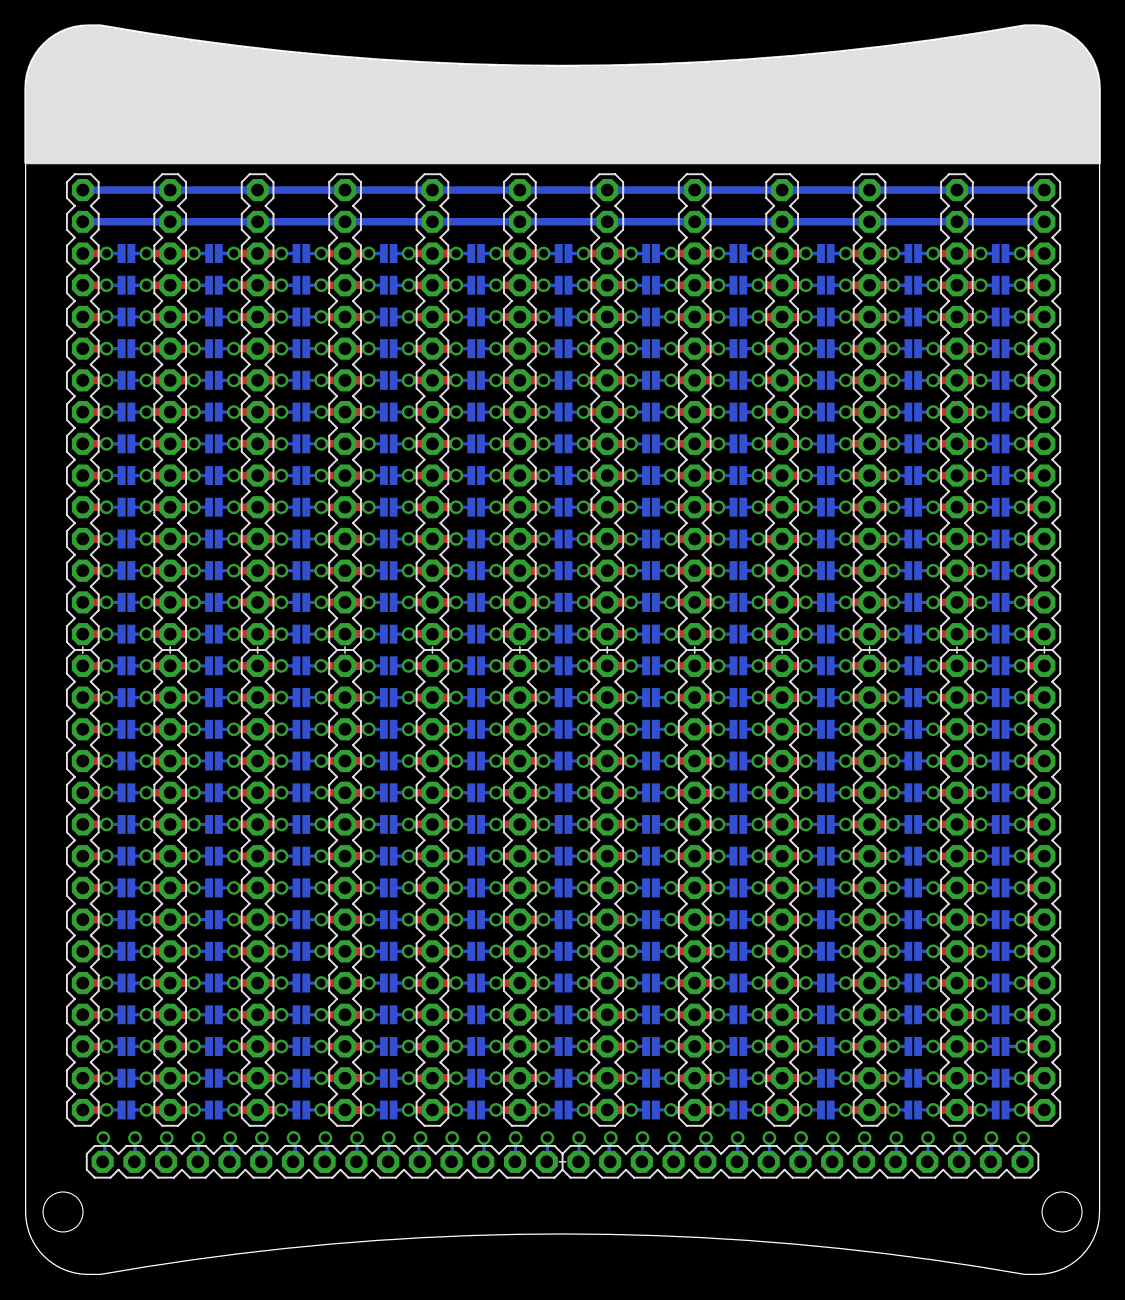
[picture p12: board Backplane.brd from above]

Board: 2 copper layers, 86.0 x 100.0 mm, 13 parts (0 on the bottom side), 30 nets.
