mengstr/XSNOR/(commit log)

2017-12-26 Rerouted for SOT23
    [AddSub.brd, AddSub.sch, Display.brd, Display.sch, ShiftReg.brd, ShiftReg.sch]
2017-12-26 Doc for pinout of PCB's
2017-12-26 Centered design on PCB
    [AddSub.brd, AddSub.sch, DRILEGEND.CFG]
2017-12-28 Add NOR2 Proto board
    [Proto2.brd, Proto2.sch]
2017-12-28 Cleanups of PCBs
    [AddSub.brd, AddSub.sch, DRILEGEND.CFG, Display.brd, Display.sch, ShiftReg.brd, ShiftReg.sch]
2017-12-29 Keyboard decoder pcb
    [Keyboard.brd, Keyboard.sch]
2017-12-30 Silk cleanup. Routing of GND instead of floodfill
    [AddSub.brd, Display.brd, Keyboard.brd, Keyboard.sch, Proto2.brd, ShiftReg.brd]
2017-12-30 Removed double label
    [Keyboard.brd]
2018-01-03 PCB template
    [pcb.brd, pcb.sch]
2018-01-03 Common generic backplane
    [Backplane.brd, Backplane.sch]
2018-01-03 Updated boards with pcb template
    [AddSub.brd, AddSub.sch, Proto2.brd, Proto2.sch, ShiftReg.brd, ShiftReg.sch]
2018-01-03 Minor cleanup of board
    [Display.brd]
2018-01-03 12 step Johnsson counter (not finished)
    [Johnson.brd, Johnson.sch]
2018-01-04 Finished Jonsson counter pcb
    [Johnson.brd, Johnson.sch]
2018-01-04 Logic simulation of Johnson counter
    [Johnson.circ]
2018-01-04 Added component count on layer 49
    [AddSub.brd, Backplane.brd, Display.brd, Johnson.brd, Keyboard.brd, Proto2.brd, ShiftReg.brd, pcb.brd]
2018-01-05 Updated with pcb template
    [Keyboard.brd]
2018-01-11 Added clear to ShiftReg
    [ShiftReg.brd, ShiftReg.sch]
2018-01-12 Shiftreg pcb have its own inverters for control signals
    [ShiftReg.brd, ShiftReg.sch]
